NiKiZe/AtTiny85HVP/Schematics/Schematics.sch

## KiCad design Schematics/Schematics.sch (2018-01-04)

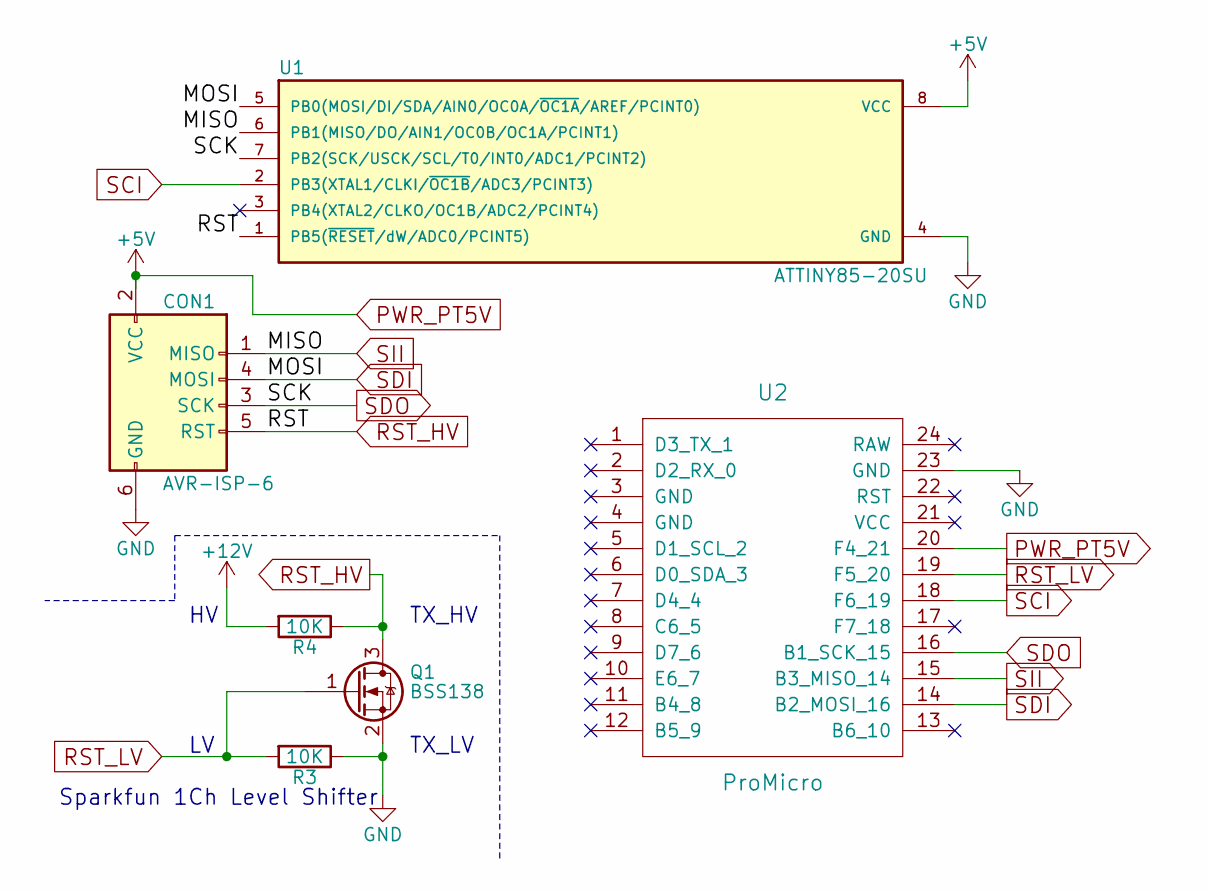
[picture p3: schematic Schematics.sch]

Parts:
CON1: AVR-ISP-6
Q1: BSS138; SOT-23
R3, R4: 10K
U1: ATTINY85-20SU; SOIC-8_3.9x4.9mm_Pitch1.27mm
U2: ProMicro

Connections:
+5V: CON1.2 (VCC), U1.8 (VCC), U2.20 (F4_21)
+12V: R4.2
GND: CON1.6 (GND), Q1.2 (S), R3.1, U1.4 (GND), U2.23 (GND)
RST_HV: CON1.5 (RST), Q1.3 (D), R4.1, U1.1 (PB5(~RESET~/dW/ADC0/PCINT5))
RST_LV: Q1.1 (G), R3.2, U2.19 (F5_20)
SCI: U1.2 (PB3(XTAL1/CLKI/~OC1B~/ADC3/PCINT3)), U2.18 (F6_19)
SDI: CON1.4 (MOSI), U1.5 (PB0(MOSI/DI/SDA/AIN0/OC0A/~OC1A~/AREF/P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), U2.14 (B2_MOSI_16)
SDO: CON1.3 (SCK), U1.7 (PB2(SCK/USCK/SCL/T0/INT0/ADC1/PCINT2)), U2.16 (B1_SCK_15)
SII: CON1.1 (MISO), U1.6 (PB1(MISO/DO/AIN1/OC0B/OC1A/PCINT1)), U2.15 (B3_MISO_14)

Notes on the sheet:
TX_LV
TX_HV
Sparkfun 1Ch Level Shifter
