NiKiZe/AtTiny85HVP/(commit log)

2018-01-04 Original ATTinyFuseReset import by Wayne Holder found at https://sites.google.com/site/wayneholder/attiny-fuse-reset
    [ATTinyFuseReset.ino]
2018-01-04 Add basic schema for HVP from Pro Micro
    [Schematics.sch]
2018-01-04 Add initial documentation, based on tsaarni/avr-high-voltage-serial-programming README
2018-01-04 Update FUSE program to use ProMicro pinout from schematics Also add some debug output to help determine state, and success or failure
    [ATTinyFuseReset.ino]
2018-01-04 Show the resulting circuit, and how absolutely horrible it looks, but it works!
